ryood/PCM2704_HPA/IMG_20191226_172557.jpg

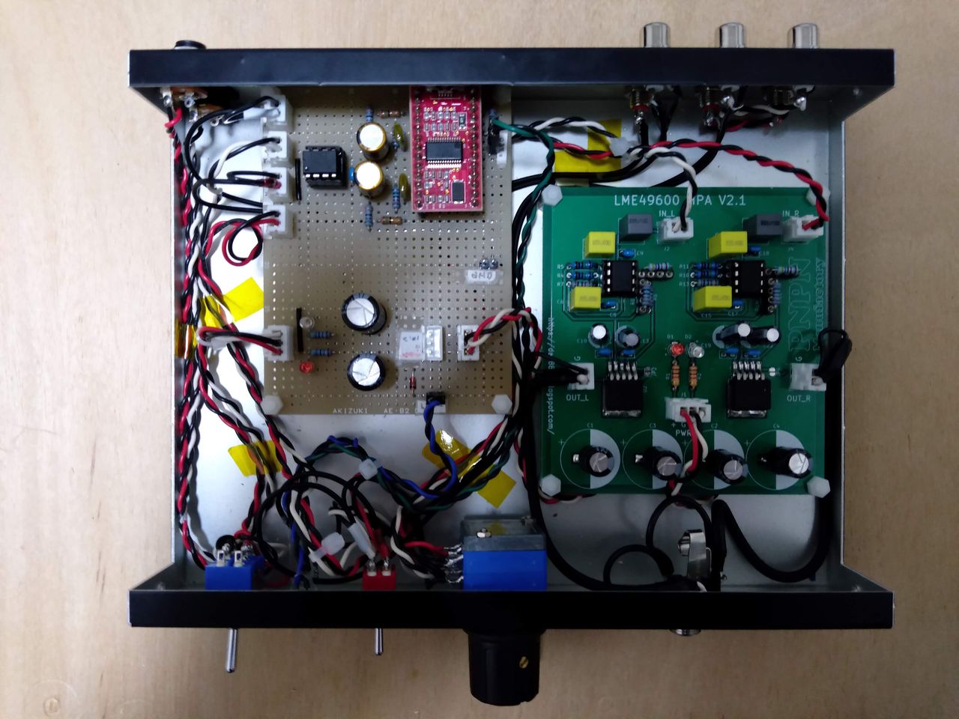
IMG_20191226_172557.jpg
