ryood/PCM2704_HPA/PCM2704_HPA_Substrate.jpg

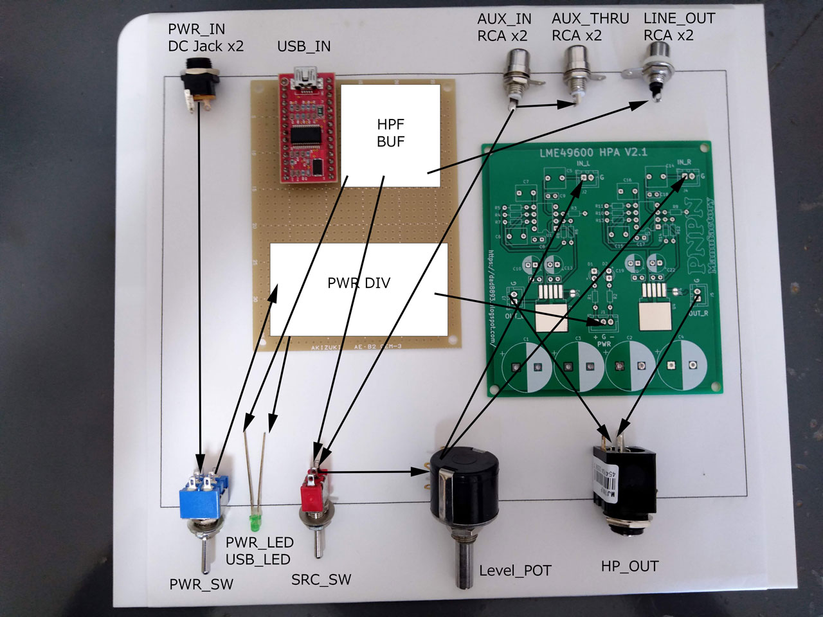
PCM2704_HPA_Substrate.jpg
