ryood/PCM2704_HPA/flitzing/PCM2704_HPA_Case_ブレッドボード.png

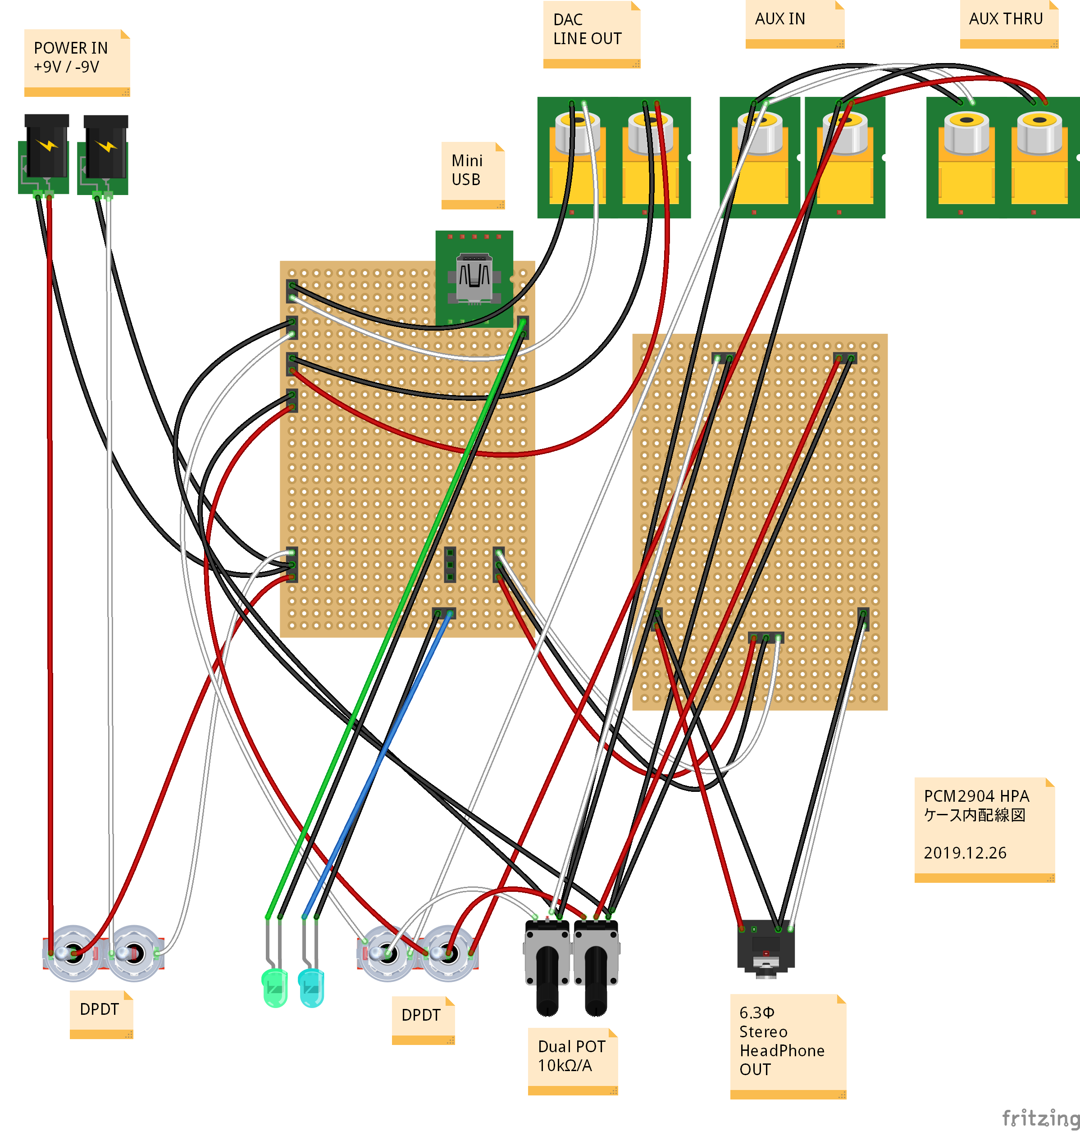
flitzing/PCM2704_HPA_Case_ブレッドボード.png
