ryood/PCM2704_HPA/flitzing/PCM2704_LineAmp_Snubber_ブレッドボード.png

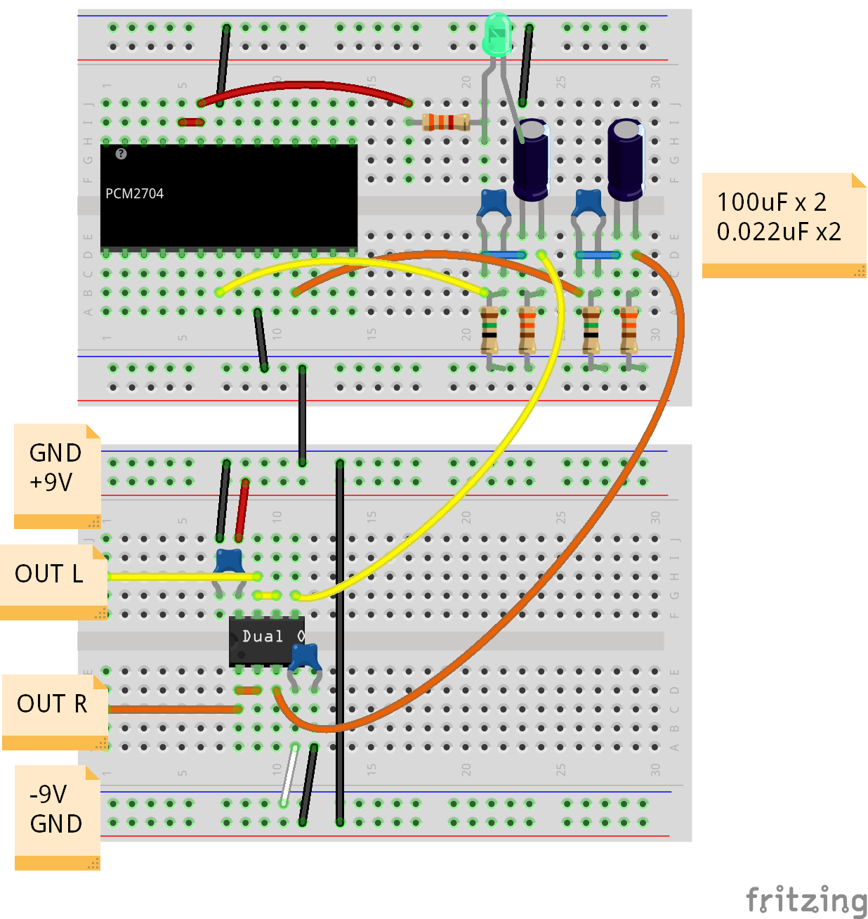
flitzing/PCM2704_LineAmp_Snubber_ブレッドボード.png
