ryood/PCM2704_HPA/flitzing/PCM2704_LineAmp_ブレッドボード.png

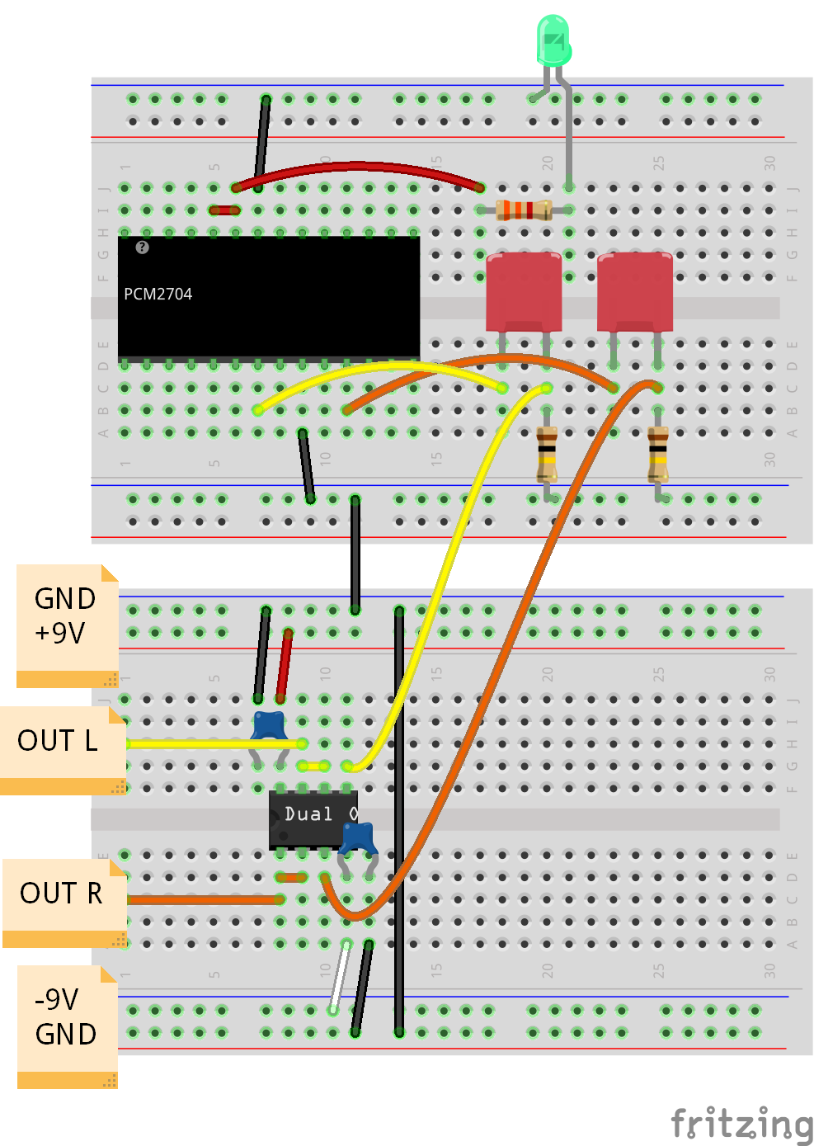
flitzing/PCM2704_LineAmp_ブレッドボード.png
