ryood/PCM2704_HPA/IMG_20190929_0001.jpg

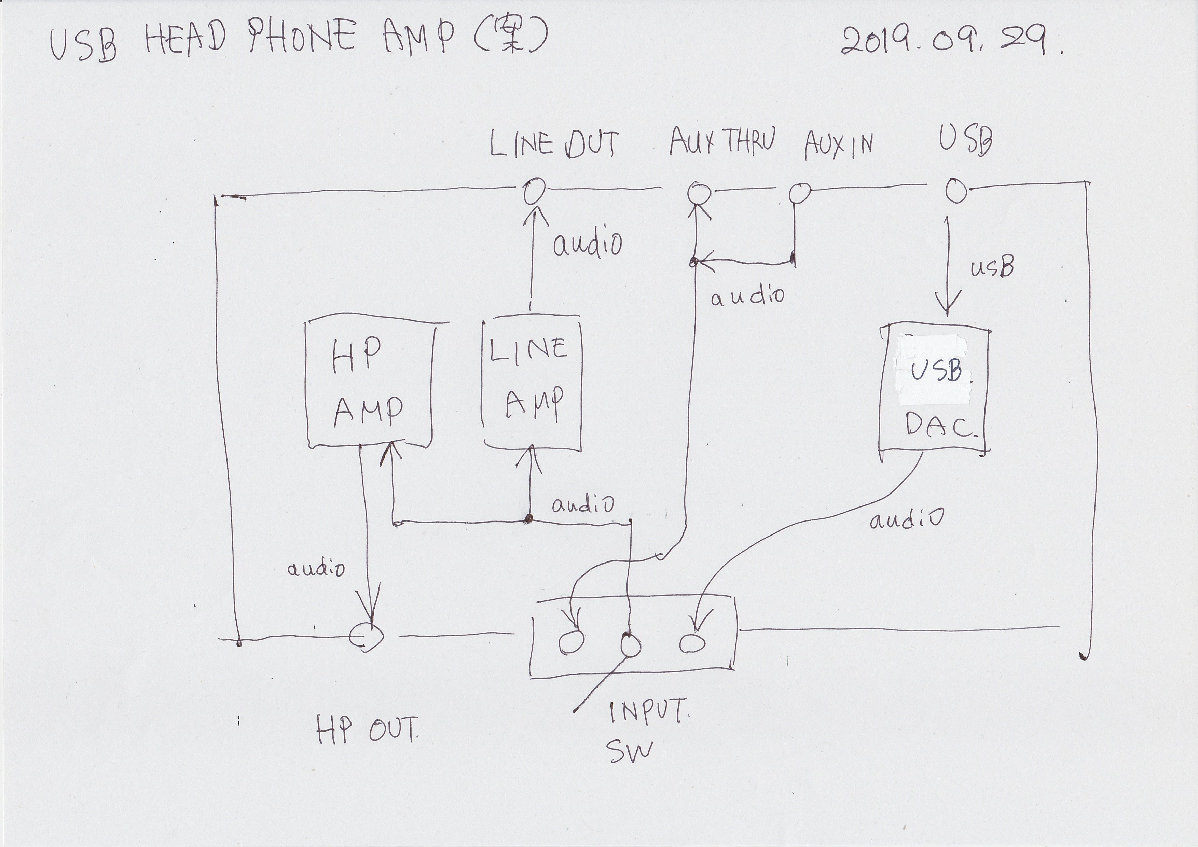
IMG_20190929_0001.jpg
