ryood/PCM2704_HPA/IMG_20191007_0001.jpg

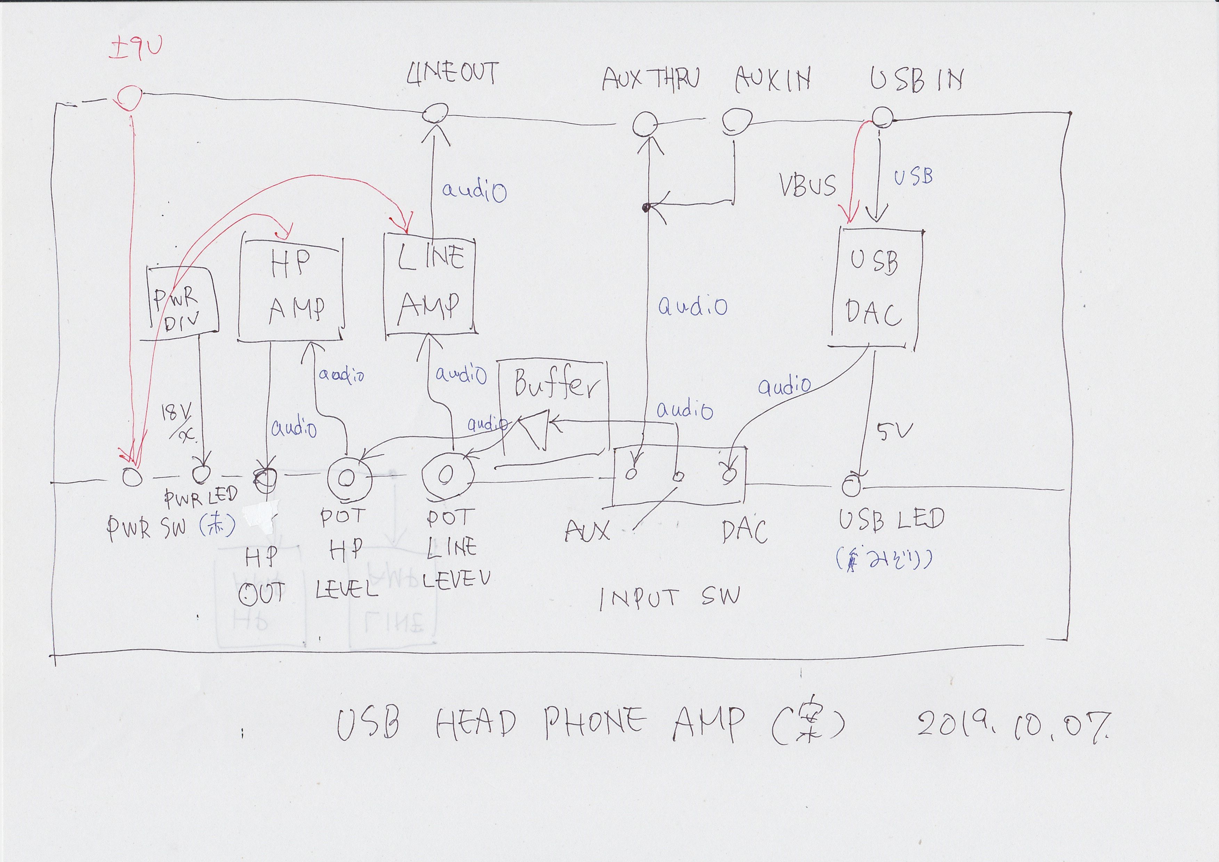
IMG_20191007_0001.jpg
