ryood/PCM2704_HPA/KiCAD/LME49600_HPA.jpg

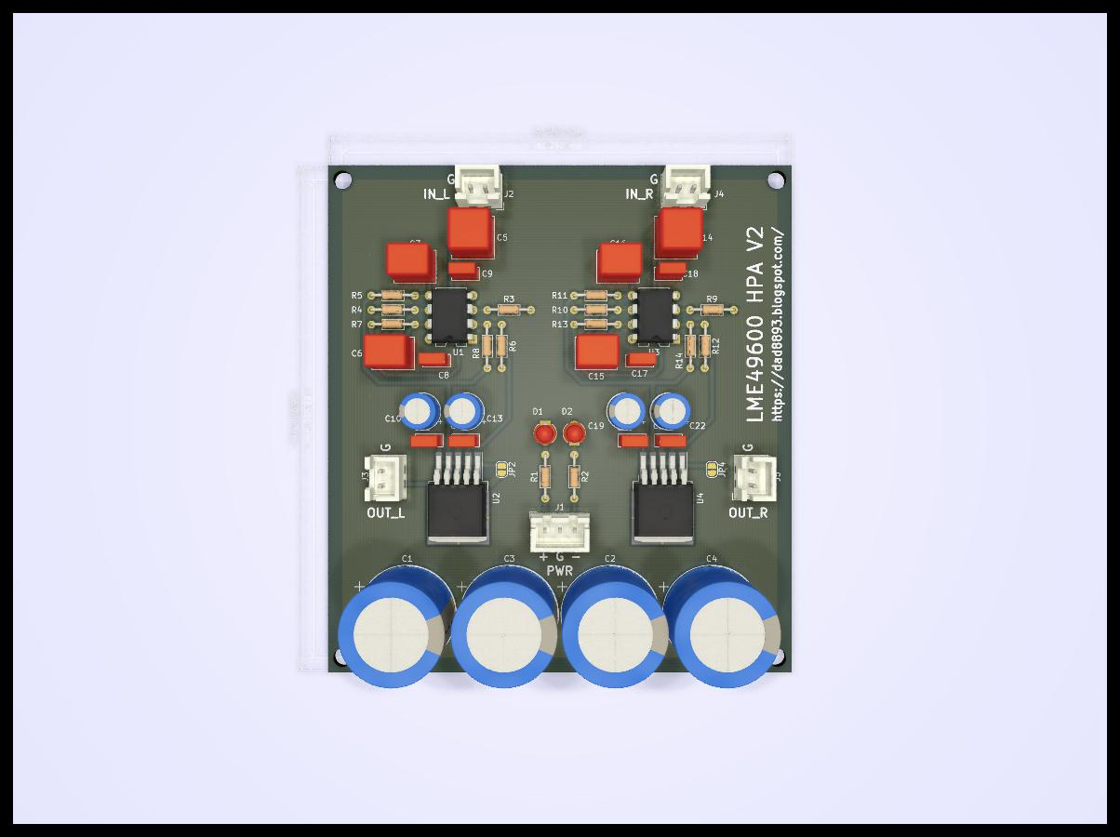
KiCAD/LME49600_HPA.jpg
