ryood/PCM2704_HPA/KiCAD/LME49600_HPA_3.jpg

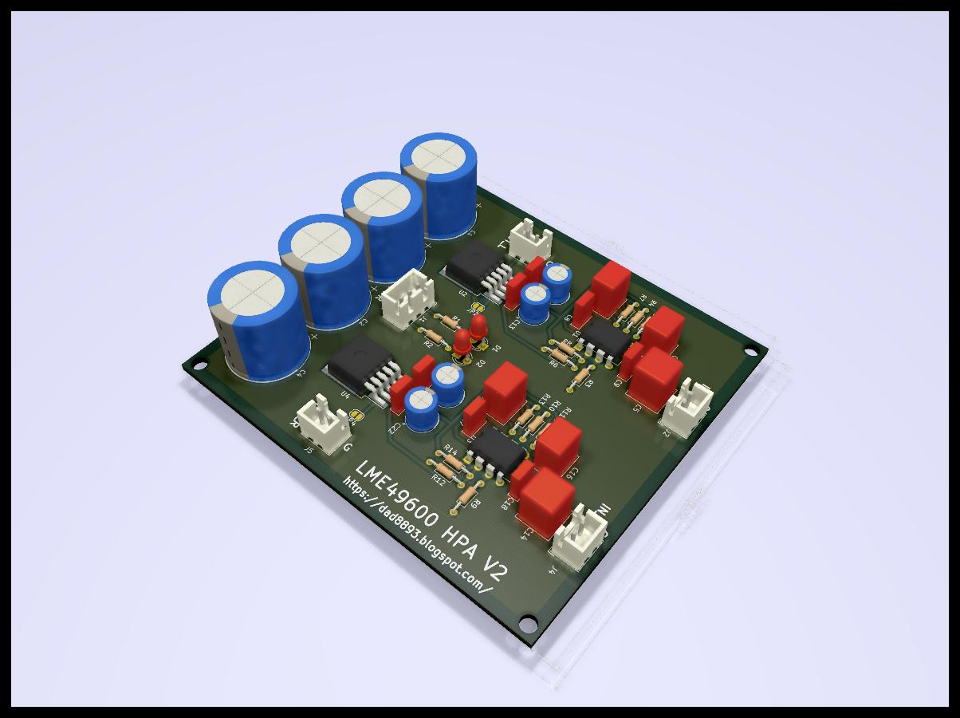
KiCAD/LME49600_HPA_3.jpg
