ryood/PCM2704_HPA/KiCAD/LME49600_HPA_rear.jpg

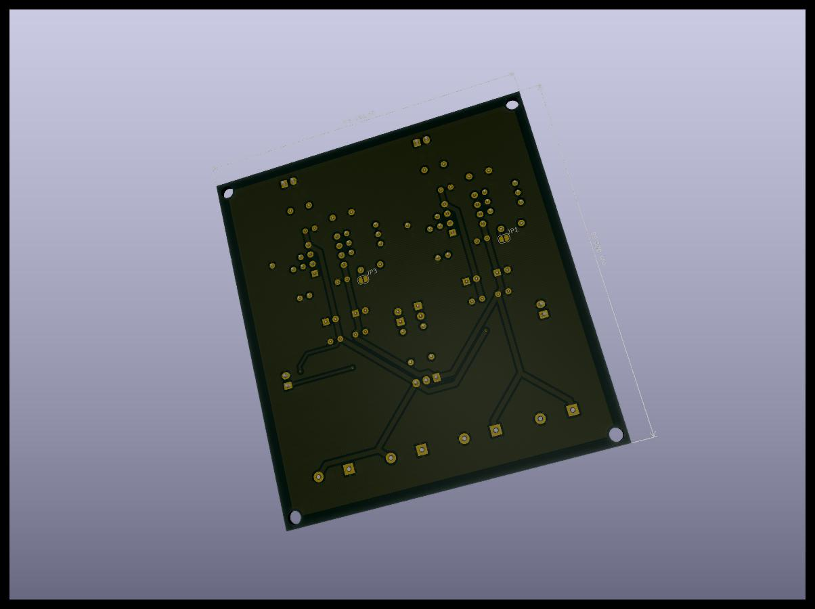
KiCAD/LME49600_HPA_rear.jpg
