ryood/PCM2704_HPA/KiCAD/LME49600_HPA_V2_sch.PNG

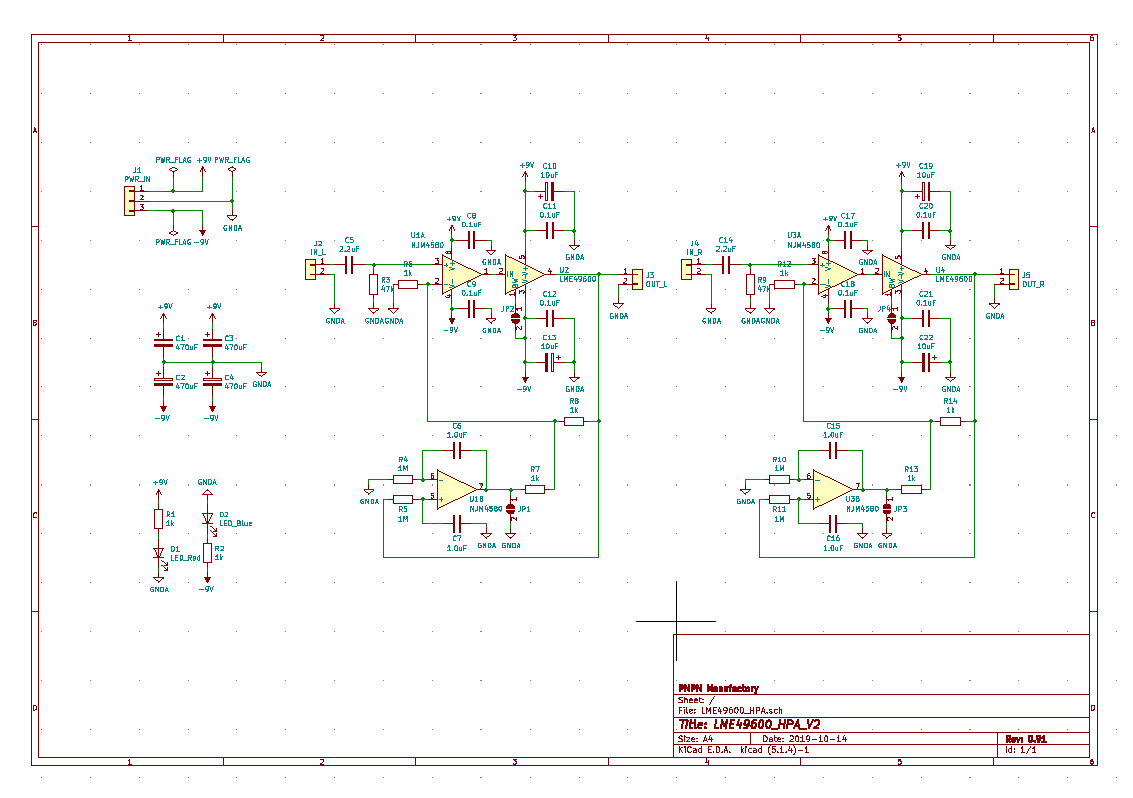
KiCAD/LME49600_HPA_V2_sch.PNG
