ryood/PCM2704_HPA/KiCAD/PCM2704_HPA_LineAmp_brd.png

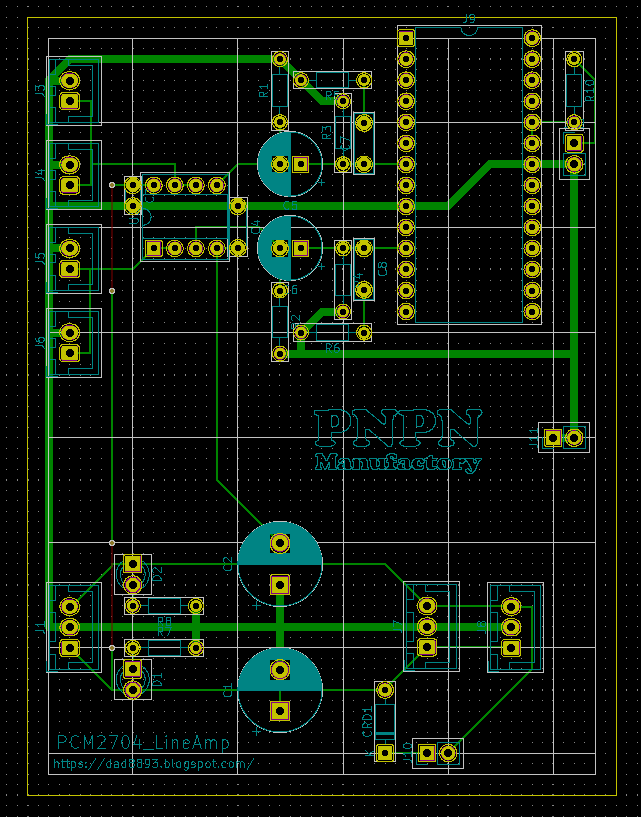
KiCAD/PCM2704_HPA_LineAmp_brd.png
