ryood/PCM2704_HPA/KiCAD/PCM2704_HPA_LineAmp_sch.png

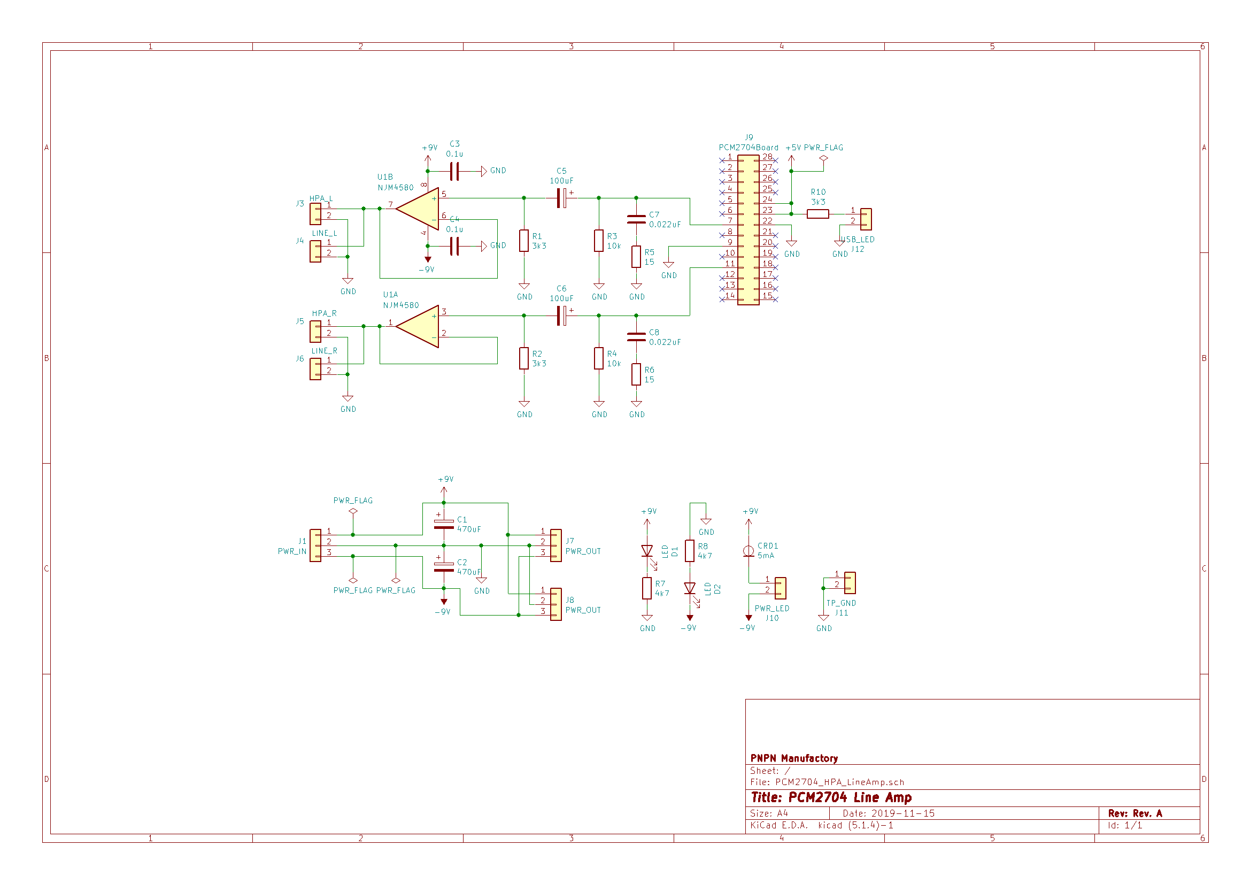
KiCAD/PCM2704_HPA_LineAmp_sch.png
