ryood/PCM2704_HPA/LME49600 HPA_sch.png

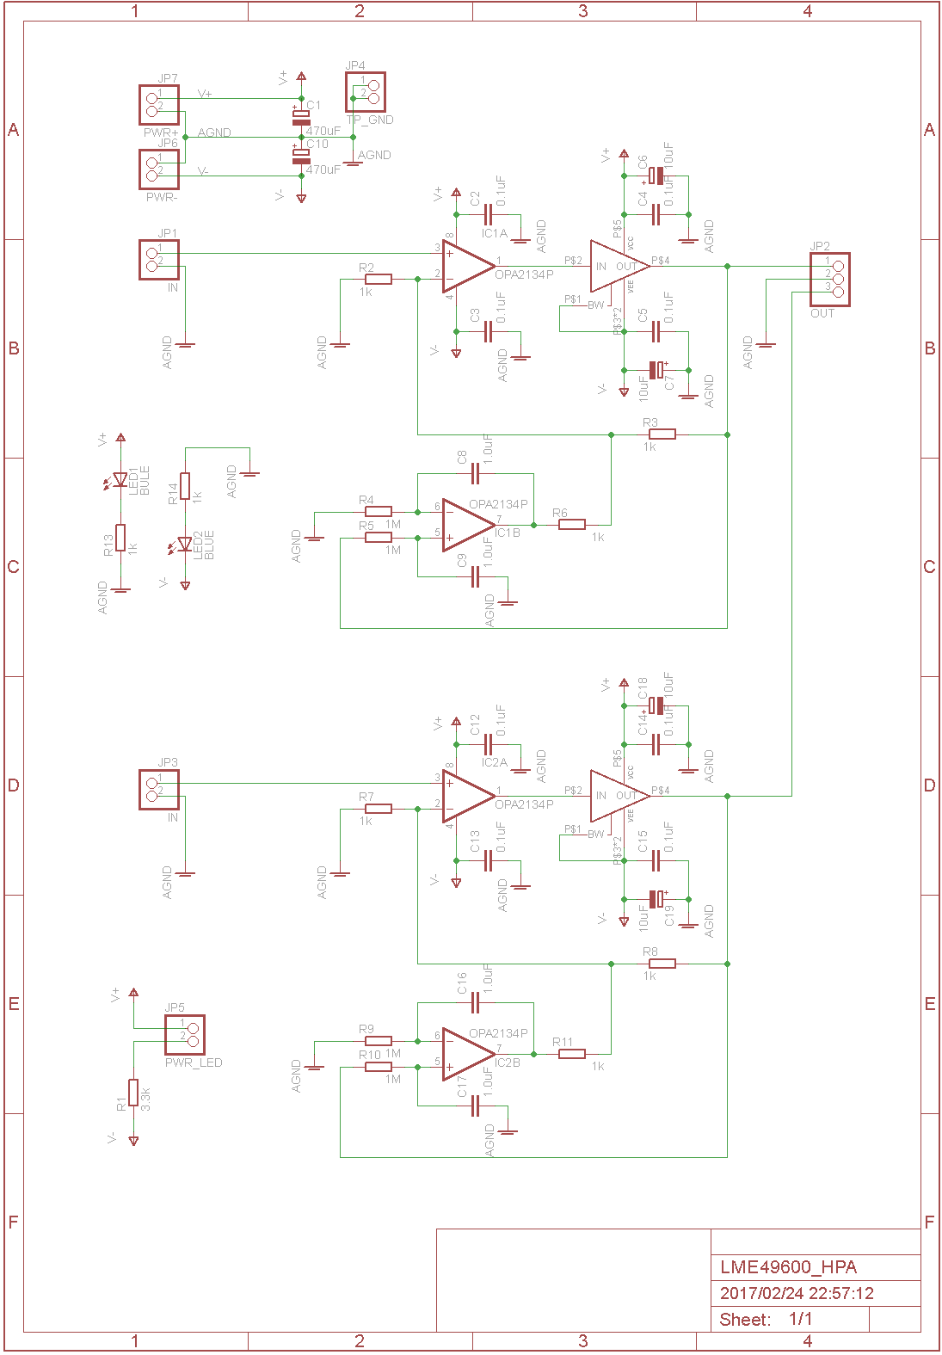
LME49600 HPA_sch.png
