ryood/PCM2704_HPA/spice/snubber_ac.png

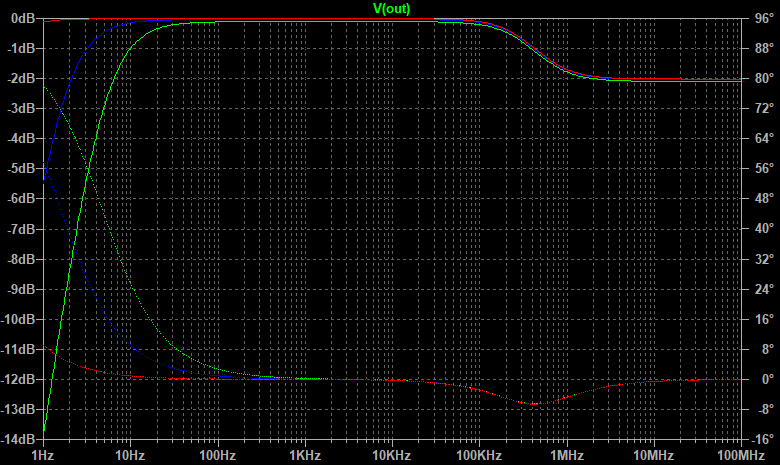
spice/snubber_ac.png
