ryood/PCM2704_HPA/spice/snubber_sch.png

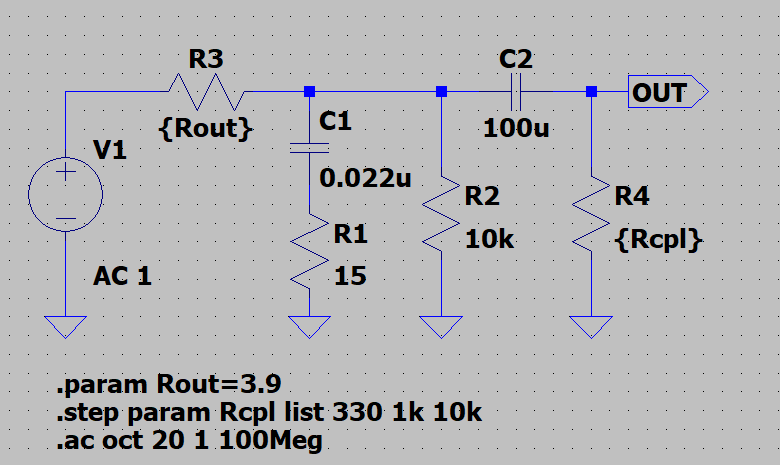
spice/snubber_sch.png
