ryood/PCM2704_HPA/logo/PNPN_Manufactory.dxf

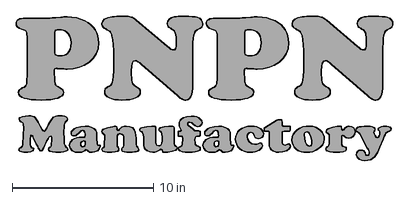
[picture p18: CAD file, 2019-10-29]
logo/PNPN_Manufactory.dxf
26.6 x 10.2 in
