ryood/PCM2704_HPA/(list of files, cad)

Other CAD files:
cad/PCM2704_HPA_Case.dwg
cad/PCM2704_HPA_Case_Bottom.dwg
logo/PNPN_Manufactory.dwg
