ryood/PCM2704_HPA/cad/PCM2704_HPA_Case.pdf

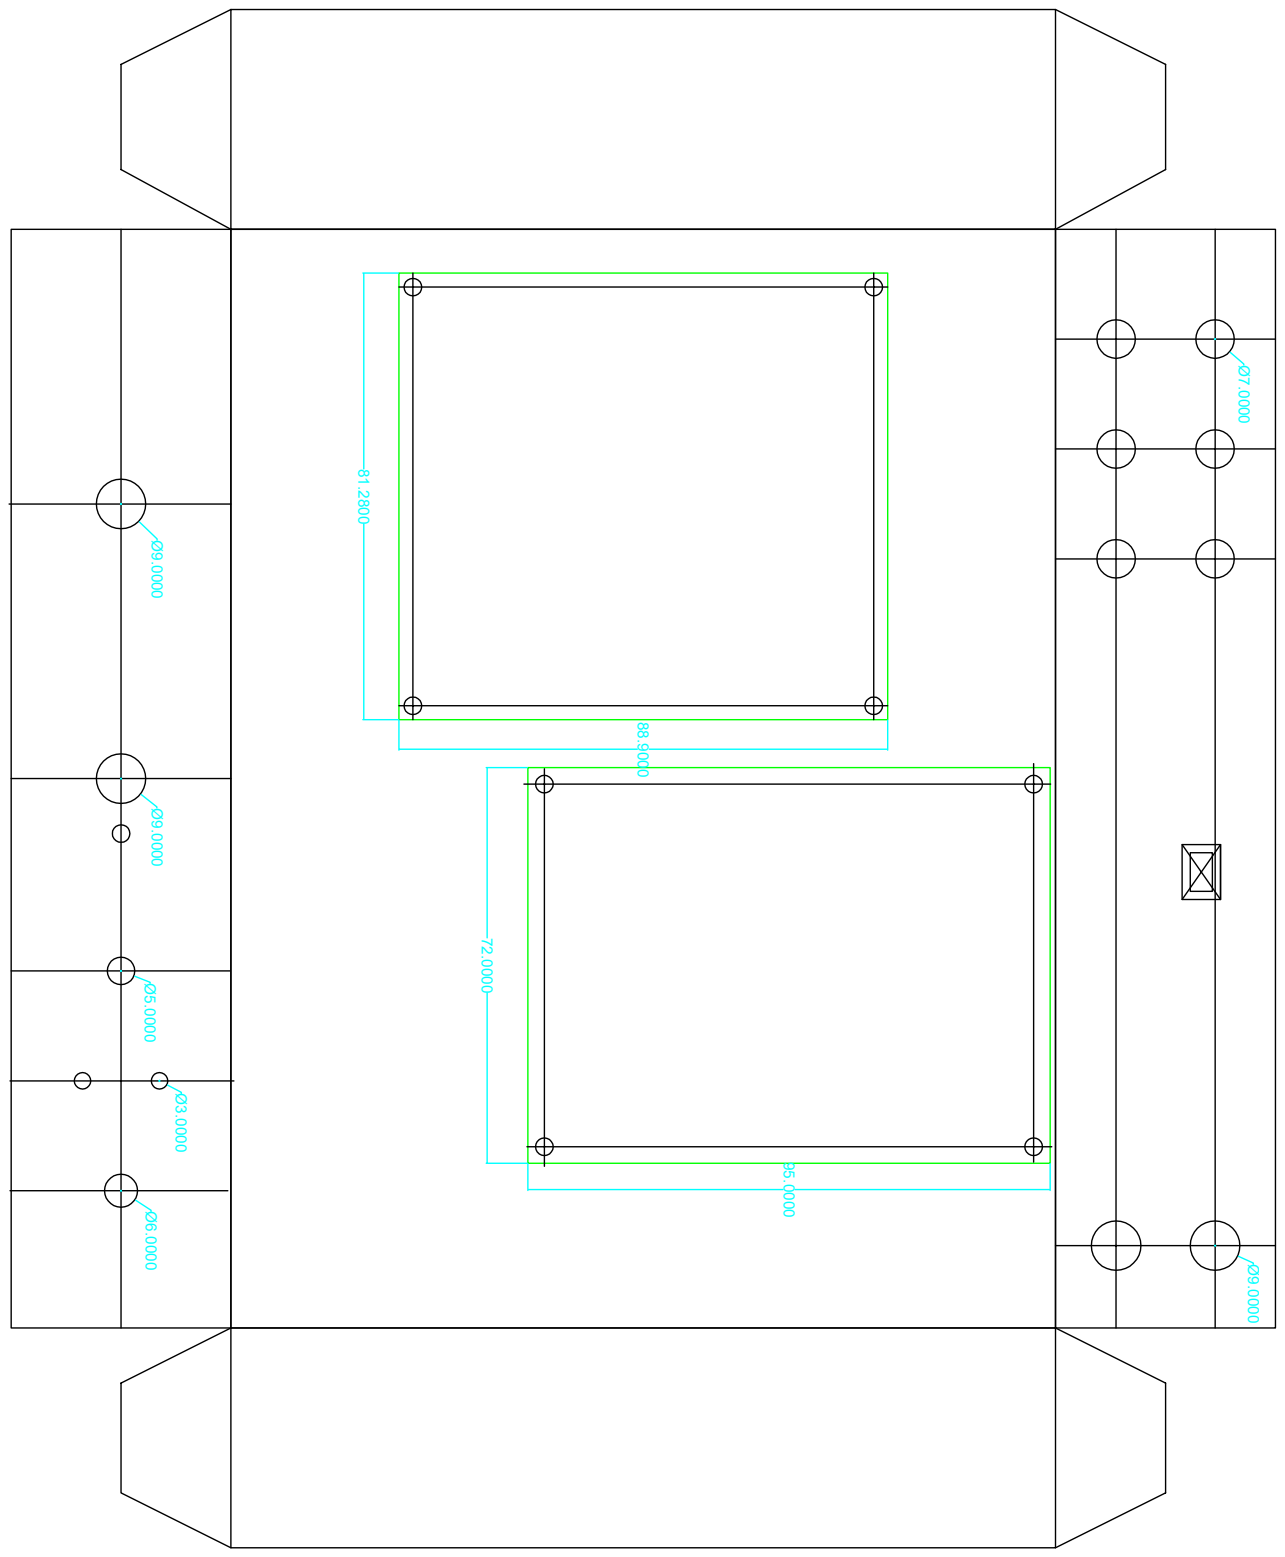
[picture p19: page 1]
