ryood/PCM2704_HPA/doc/AKI-DAC-REVC_1a_20171226.pdf

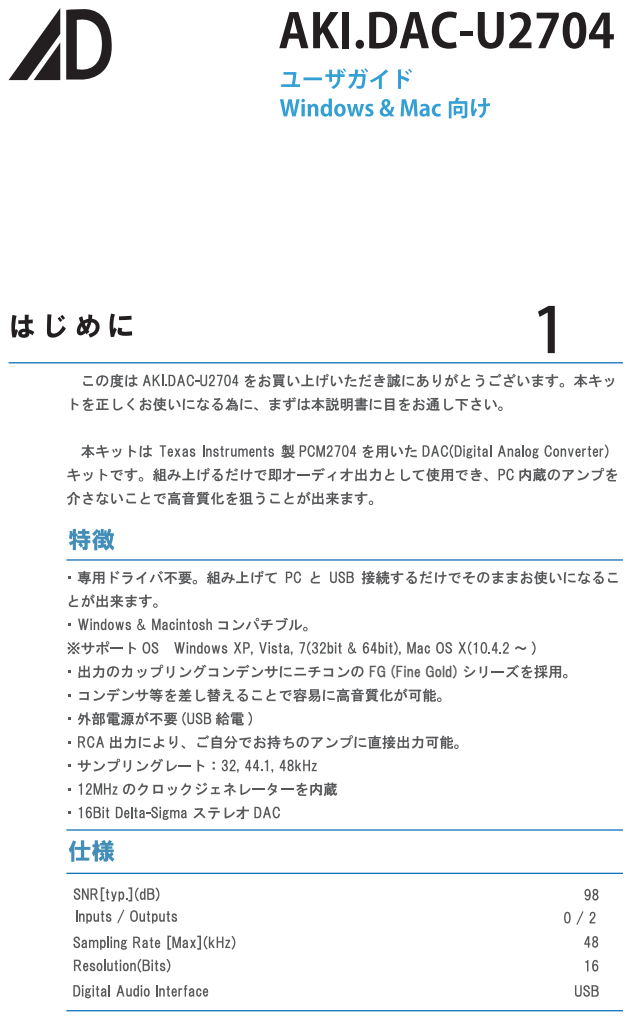
[picture p20: page 1]

FG (Fine Gold)

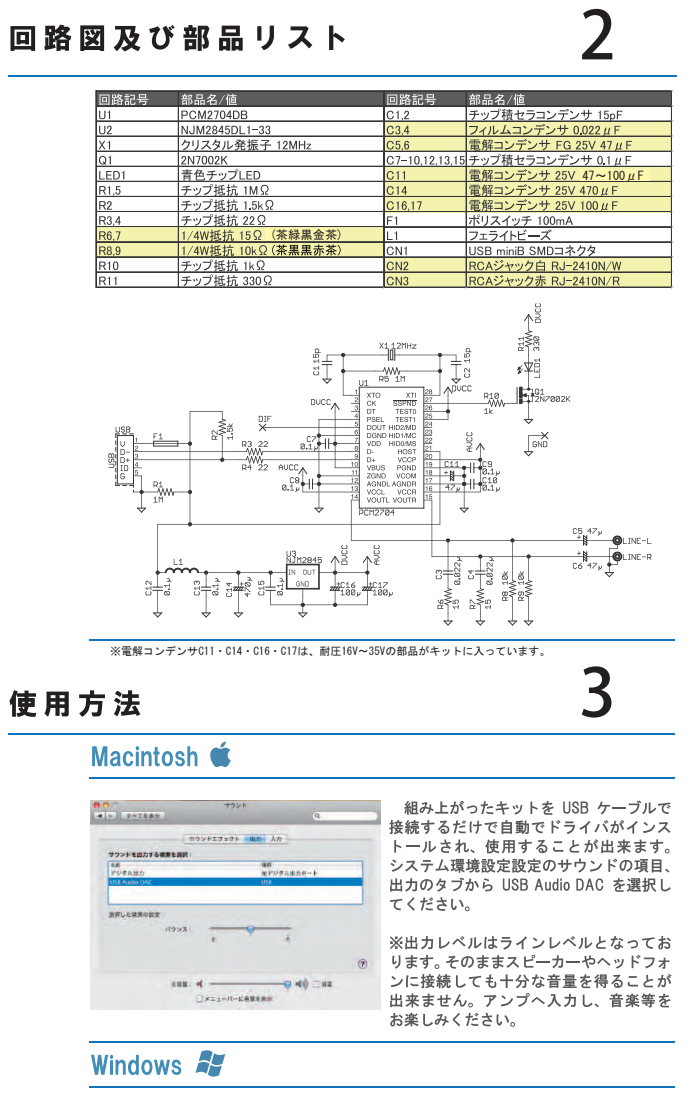
[picture p21: page 2]
(茶緑黒金茶); ※電解コンデンサC11・C14・C16・C17は、耐圧16V～35Vの部品がキットに入っています。

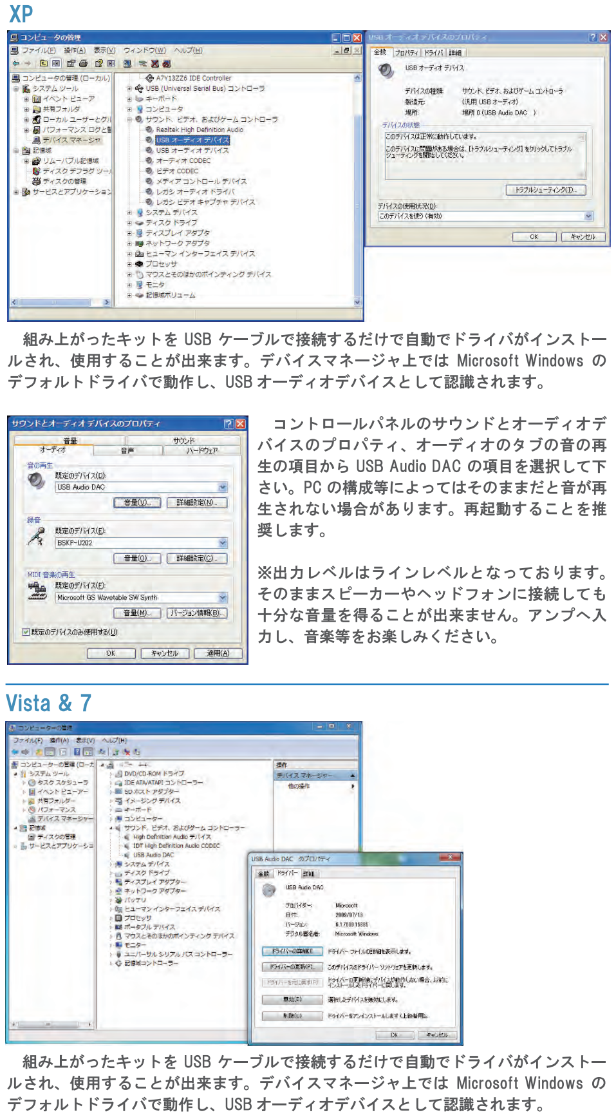
[picture p22: page 3]

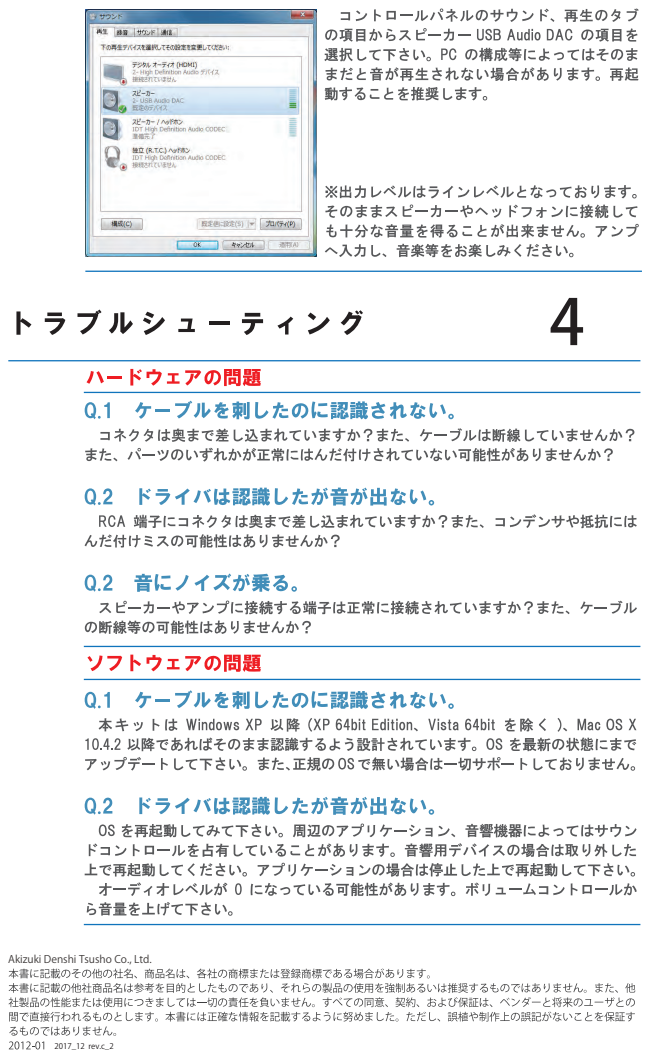
[picture p23: page 4]
2017_12 rev.c_2

Akizuki Denshi Tsusho Co., Ltd.
