ryood/PCM2704_HPA/spice/PCM2704_Snubber.asc

C1: cap; 0.022u
C2: cap; 100u
R1: res; 15
R2: res; 10k
R3: res; {Rout}
R4: res; {Rcpl}
V1: voltage; ""; AC 1
Named nets: 0, OUT
.param Rout=3.9
.ac oct 20 1 100Meg
.step param Rcpl list 330 1k 10k
