ryood/PCM2704_HPA/(list of files, drawings)

Other design files:
flitzing/PCM2704_HPA_Case.fzz
flitzing/PCM2704_LineAmp.fzz
flitzing/PCM2704_LineAmp_Snubber.fzz
