ryood/PCM2704_HPA/KiCAD/PCM2704_HPA_LineAmp/PCM2704_HPA_LineAmp.kicad_pcb

## KiCad design KiCAD/PCM2704_HPA_LineAmp/PCM2704_HPA_LineAmp.kicad_pcb (2019-11-29)

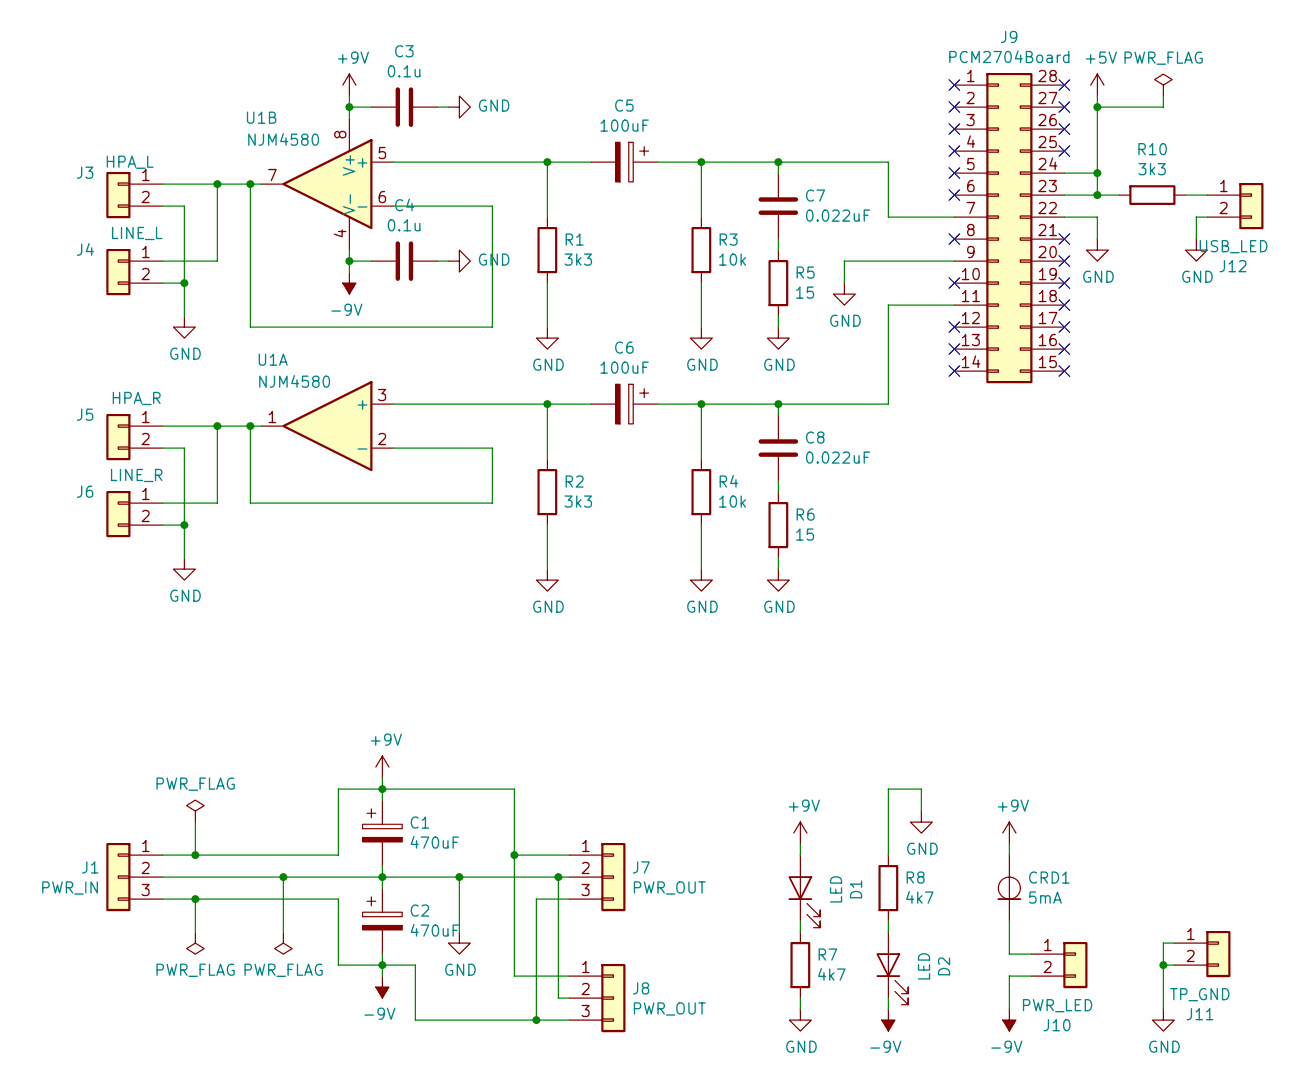
[picture p24: schematic PCM2704_HPA_LineAmp.sch, PCM2704 Line Amp]

Parts:
C1, C2: 470uF; CP_Radial_D10.0mm_P5.00mm
C3: 0.1u; C_Disc_D3.0mm_W1.6mm_P2.50mm
C4: 0.1u; C_Disc_D4.3mm_W1.9mm_P5.00mm
C5, C6: 100uF; CP_Radial_D7.5mm_P2.50mm
C7, C8: 0.022uF; C_Rect_L7.0mm_W2.0mm_P5.00mm
CRD1: 5mA; D_DO-35_SOD27_P7.62mm_Horizontal
D1, D2: LED; LED_D3.0mm
J1: PWR_IN; JST_XH_B3B-XH-A_1x03_P2.50mm_Vertical
J3: HPA_L; JST_XH_B2B-XH-A_1x02_P2.50mm_Vertical
J4: LINE_L; JST_XH_B2B-XH-A_1x02_P2.50mm_Vertical
J5: HPA_R; JST_XH_B2B-XH-A_1x02_P2.50mm_Vertical
J6: LINE_R; JST_XH_B2B-XH-A_1x02_P2.50mm_Vertical
J7, J8: PWR_OUT; JST_XH_B3B-XH-A_1x03_P2.50mm_Vertical
J9: PCM2704Board; DIP-28_W15.24mm
J10: PWR_LED; PinHeader_1x02_P2.54mm_Vertical
J11: TP_GND; PinHeader_1x02_P2.54mm_Vertical
J12: USB_LED; PinHeader_1x02_P2.54mm_Vertical
R1, R2, R10: 3k3; R_Axial_DIN0204_L3.6mm_D1.6mm_P7.62mm_Horizontal
R3, R4: 10k; R_Axial_DIN0204_L3.6mm_D1.6mm_P7.62mm_Horizontal
R5, R6: 15; R_Axial_DIN0204_L3.6mm_D1.6mm_P7.62mm_Horizontal
R7, R8: 4k7; R_Axial_DIN0204_L3.6mm_D1.6mm_P7.62mm_Horizontal
U1: NJM4580; DIP-8_W7.62mm_Socket

Connections:
+5V: J9.23, J9.24, R10.2
+9V: C1.1, C3.1, CRD1.2 (A), D1.2 (A), J1.1, J7.1, J8.1, U1.8 (V+)
-9V: C2.2, C4.2, D2.1 (K), J1.3, J7.3, J8.3, J10.2, U1.4 (V-)
GND: C1.2, C2.1, C3.2, C4.1, J1.2, J3.2, J4.2, J5.2, J6.2, J7.2, J8.2, J9.9, J9.22, J11.1, J11.2, J12.2, R1.2, R2.2, R3.2, R4.2, R5.2, R6.2, R7.2, R8.1
unnamed: C5.1, C7.1, J9.7, R3.1
unnamed: C5.2, R1.1, U1.5 (+)
unnamed: C6.1, C8.1, J9.11, R4.1
unnamed: C6.2, R2.1, U1.3 (+)
unnamed: C7.2, R5.1
unnamed: C8.2, R6.1
unnamed: CRD1.1 (K), J10.1
unnamed: D1.1 (K), R7.1
unnamed: D2.2 (A), R8.2
unnamed: J3.1, J4.1, U1.6 (-), U1.7
unnamed: J5.1, J6.1, U1.1, U1.2 (-)
unnamed: J12.1, R10.1

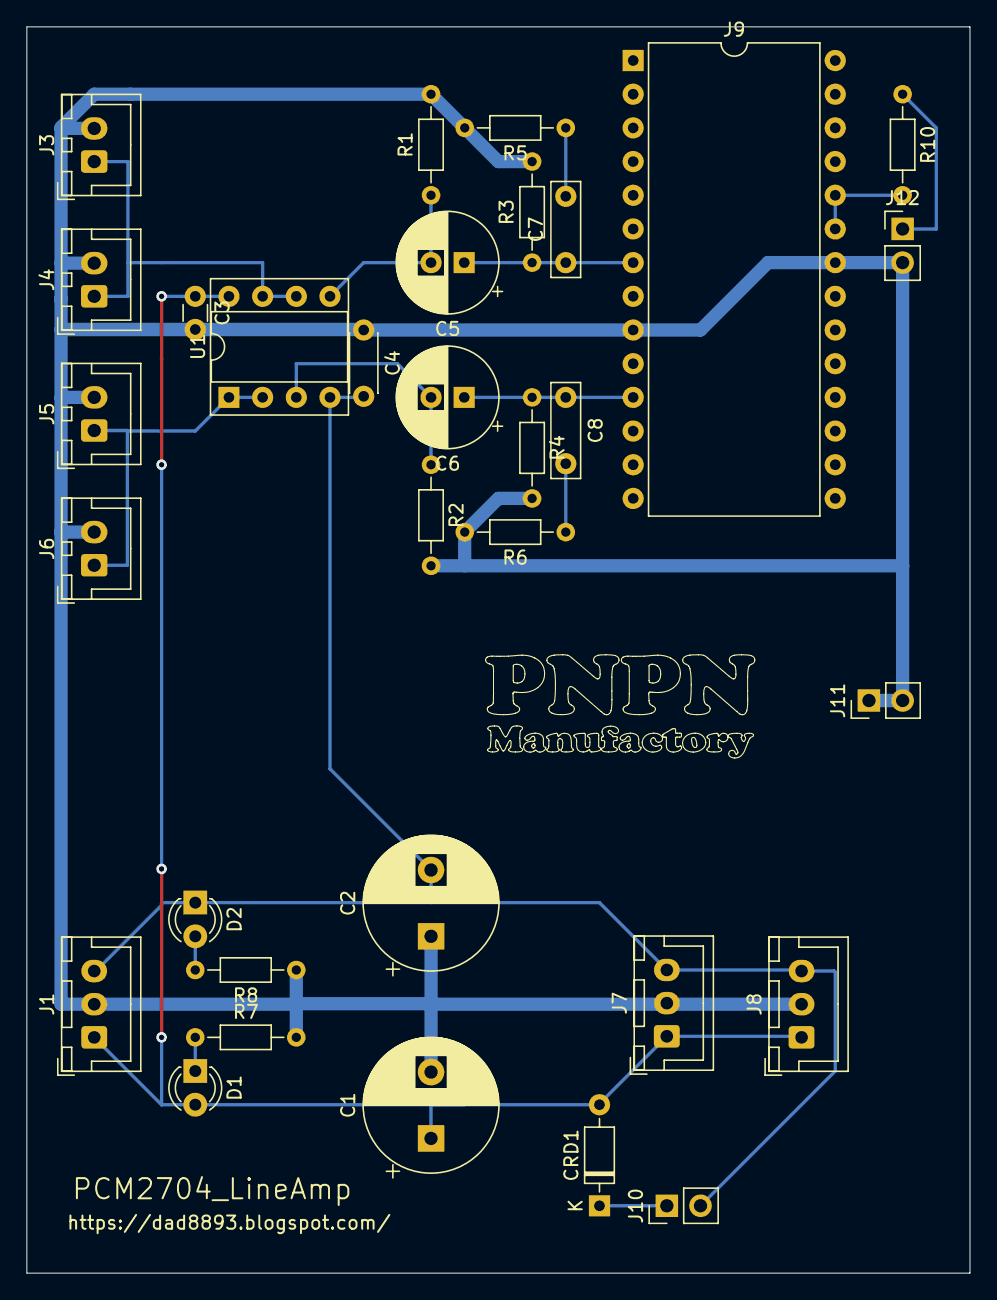
[picture p25: board PCM2704_HPA_LineAmp.kicad_pcb from above]

Board: 2 copper layers, 71.1 x 94.0 mm, 32 parts (0 on the bottom side), 16 nets.
