ryood/PCM2704_HPA/KiCAD/LME49600_HPA/LME49600_HPA.kicad_pcb

## KiCad design KiCAD/LME49600_HPA/LME49600_HPA.kicad_pcb (2019-10-29)

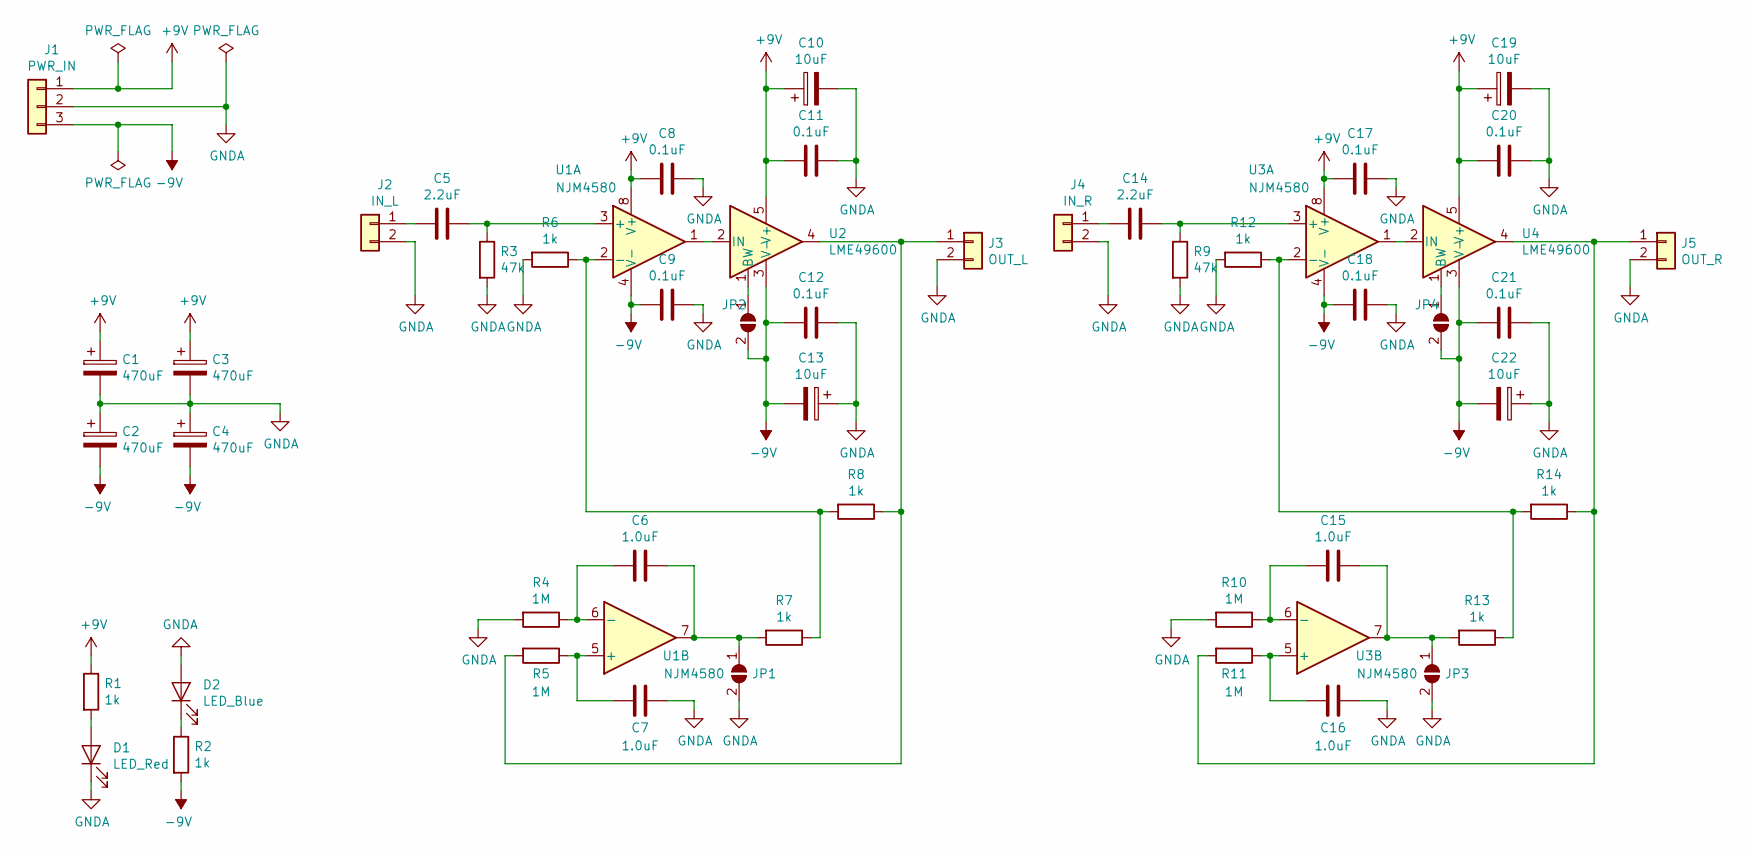
[picture p26: schematic LME49600_HPA.sch, LME49600_HPA_V2.1]

Parts:
C1, C2, C3, C4: 470uF; CP_Radial_D17.0mm_P7.50mm
C5, C14: 2.2uF; C_Rect_L7.2mm_W7.2mm_P5.00mm_FKS2_FKP2_MKS2_MKP2
C6, C7, C15, C16: 1.0uF; C_Rect_L7.2mm_W5.5mm_P5.00mm_FKS2_FKP2_MKS2_MKP2
C8, C9, C11, C12, C17, C18, C20, C21: 0.1uF; C_Rect_L4.6mm_W2.0mm_P2.50mm_MKS02_FKP02
C10, C13, C19, C22: 10uF; CP_Radial_D6.3mm_P2.50mm
D1: LED_Red; LED_D3.0mm
D2: LED_Blue; LED_D3.0mm
J1: PWR_IN; JST_XH_B3B-XH-A_1x03_P2.50mm_Vertical
J2: IN_L; JST_XH_B2B-XH-A_1x02_P2.50mm_Vertical
J3: OUT_L; JST_XH_B2B-XH-A_1x02_P2.50mm_Vertical
J4: IN_R; JST_XH_B2B-XH-A_1x02_P2.50mm_Vertical
J5: OUT_R; JST_XH_B2B-XH-A_1x02_P2.50mm_Vertical
JP1, JP2, JP3, JP4: SolderJumper_2_Open; SolderJumper-2_P1.3mm_Open_RoundedPad1.0x1.5mm
R1, R2, R6, R7, R8, R12, R13, R14: 1k; R_Axial_DIN0207_L6.3mm_D2.5mm_P7.62mm_Horizontal
R3, R9: 47k; R_Axial_DIN0207_L6.3mm_D2.5mm_P7.62mm_Horizontal
R4, R5, R10, R11: 1M; R_Axial_DIN0207_L6.3mm_D2.5mm_P7.62mm_Horizontal
U1, U3: NJM4580; DIP-8_W7.62mm_Socket_LongPads
U2, U4: LME49600; TO-263-5_TabPin3

Connections:
+9V: C1.1, C3.1, C8.2, C10.1, C11.2, C17.2, C19.1, C20.2, J1.1, R1.1, U1.8 (V+), U2.5 (V+), U3.8 (V+), U4.5 (V+)
-9V: C2.2, C4.2, C9.2, C12.2, C13.2, C18.2, C21.2, C22.2, J1.3, JP2.2 (B), JP4.2 (B), R2.2, U1.4 (V-), U2.3 (V-), U3.4 (V-), U4.3 (V-)
GNDA: C1.2, C2.1, C3.2, C4.1, C7.1, C8.1, C9.1, C10.2, C11.1, C12.1, C13.1, C16.1, C17.1, C18.1, C19.2, C20.1, C21.1, C22.1, D1.1 (K), D2.2 (A), J1.2, J2.2, J3.2, J4.2, J5.2, JP1.2 (B), JP3.2 (B), R3.2, R4.2, R6.2, R9.2, R10.2, R12.2
unnamed: C5.1, R3.1, U1.3 (+)
unnamed: C5.2, J2.1
unnamed: C6.1, JP1.1 (A), R7.2, U1.7
unnamed: C6.2, R4.1, U1.6 (-)
unnamed: C7.2, R5.1, U1.5 (+)
unnamed: C14.1, R9.1, U3.3 (+)
unnamed: C14.2, J4.1
unnamed: C15.1, JP3.1 (A), R13.2, U3.7
unnamed: C15.2, R10.1, U3.6 (-)
unnamed: C16.2, R11.1, U3.5 (+)
unnamed: D1.2 (A), R1.2
unnamed: D2.1 (K), R2.1
unnamed: J3.1, R5.2, R8.1, U2.4
unnamed: J5.1, R11.2, R14.1, U4.4
unnamed: JP2.1 (A), U2.1 (BW)
unnamed: JP4.1 (A), U4.1 (BW)
unnamed: R6.1, R7.1, R8.2, U1.2 (-)
unnamed: R12.1, R13.1, R14.2, U3.2 (-)
unnamed: U1.1, U2.2 (IN)
unnamed: U3.1, U4.2 (IN)

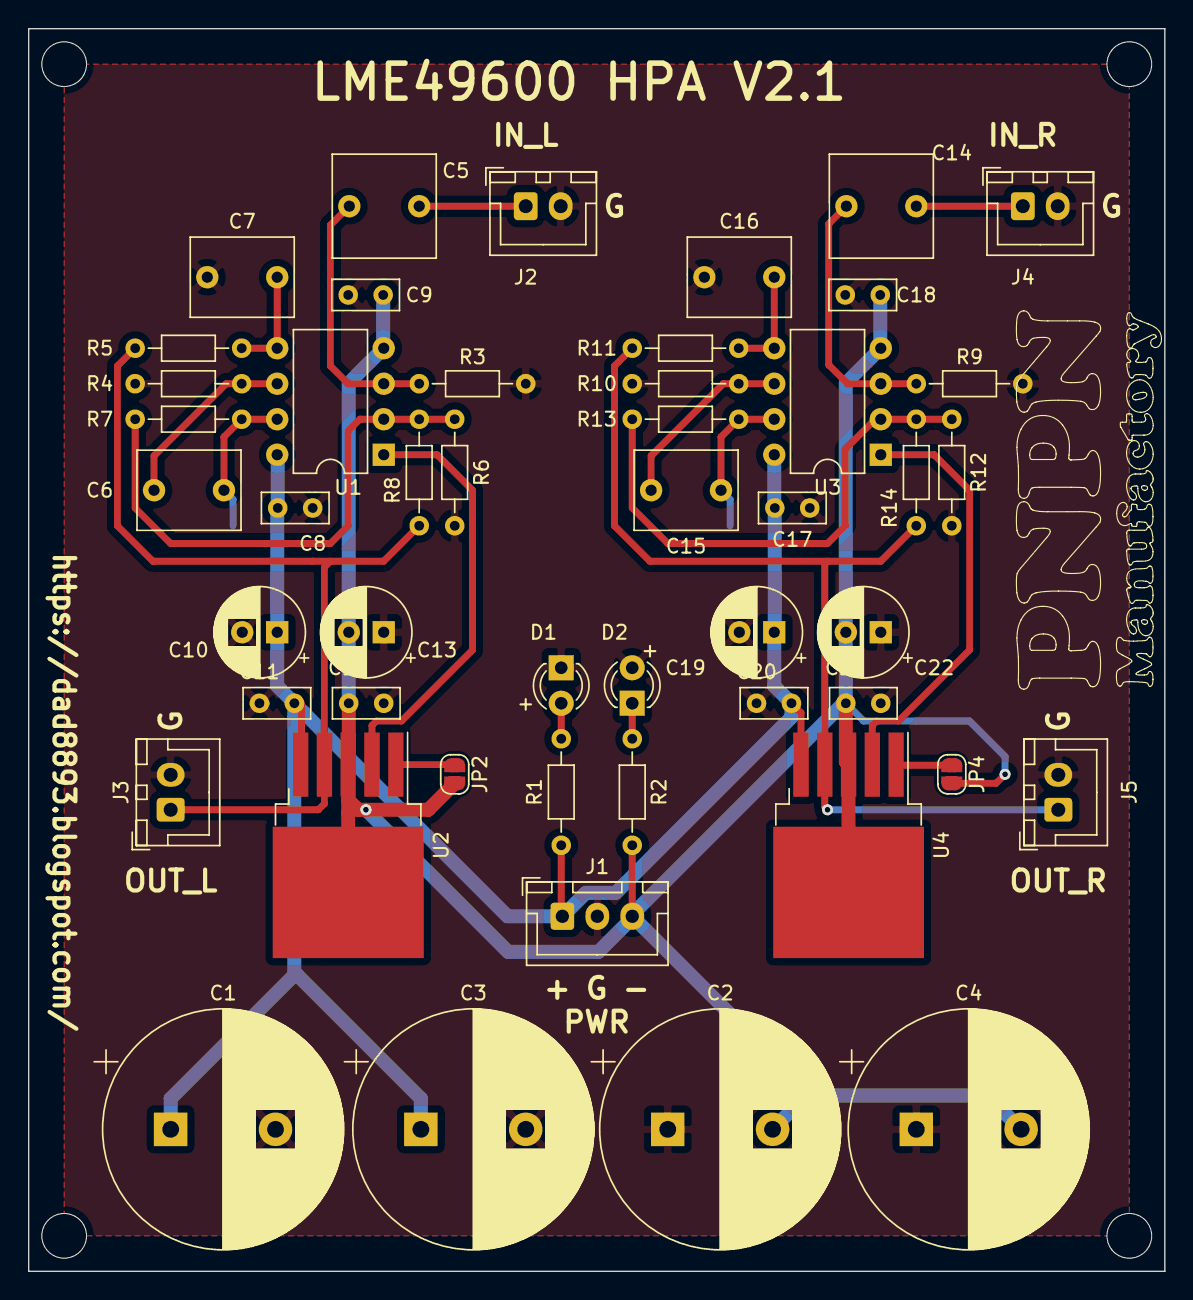
[picture p27: board LME49600_HPA.kicad_pcb from above]

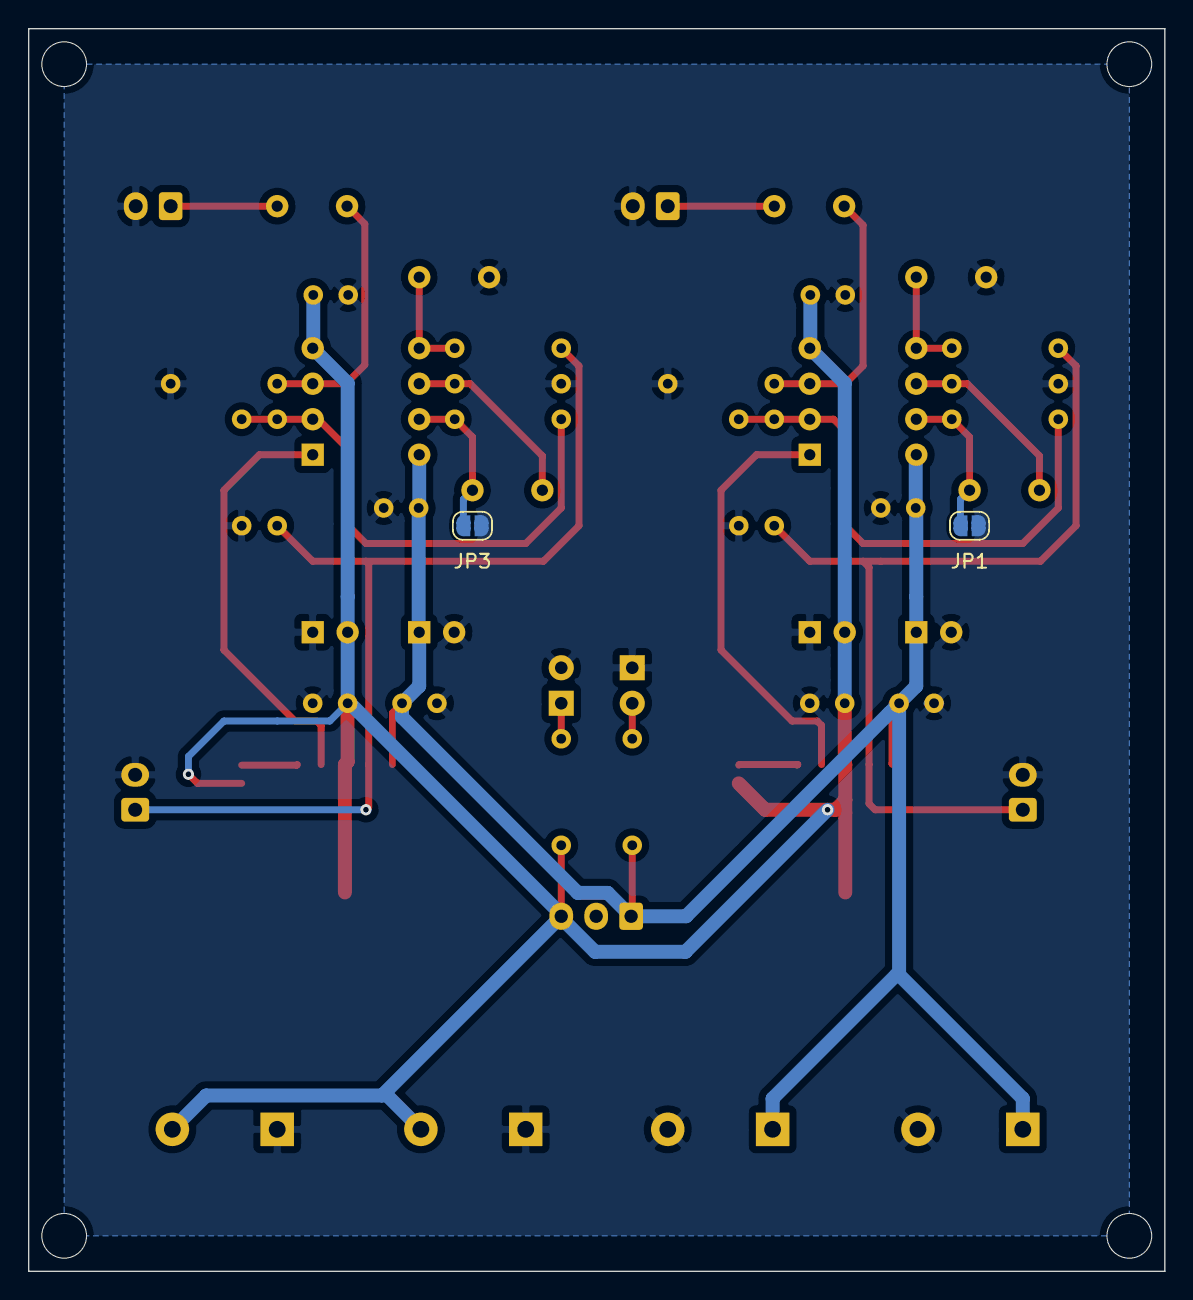
[picture p28: board LME49600_HPA.kicad_pcb from below]

Board: 2 copper layers, 81.3 x 88.9 mm, 51 parts (2 on the bottom side), 23 nets.
