ryood/PCM2704_HPA/(commit log)

2019-10-15 Add: LME49600_HPA KiCAD files.
    [LME49600_HPA-B_Cu.gbl, LME49600_HPA-B_Mask.gbs, LME49600_HPA-B_Paste.gbp, LME49600_HPA-B_SilkS.gbo, LME49600_HPA-Edge_Cuts.gm1, LME49600_HPA-F_Cu.gtl, LME49600_HPA-F_Mask.gts, LME49600_HPA-F_Paste.gtp]
2019-10-29 Add: PCM2704 HPA ブロック図.xlsx
    [LME49600_HPA-B_Cu.gbl, LME49600_HPA-B_Mask.gbs, LME49600_HPA-B_Paste.gbp, LME49600_HPA-B_SilkS.gbo, LME49600_HPA-Edge_Cuts.gm1, LME49600_HPA-F_Cu.gtl, LME49600_HPA-F_Mask.gts, LME49600_HPA-F_Paste.gtp]
2019-10-29 Update: PCM2704 HPA ブロック図.xlsx
    [PCM2704 HPA ブロック図.xlsx]
2019-11-08 Add: PCM2704_LineAmp
    [PCM2704 HPA ブロック図 AUXバッファあり.xlsx, PCM2704 HPA ブロック図.xlsx, PCM2704 HPA 基板配置.xlsx, PCM2704_HPA_LineAmp.sch, PCM2704_LineAmp_Snubber.fzz, スナバインピーダンス.xlsx]
2019-11-09 Update: PCM2704_HPA_LineAmp board design
    [PCM2704_HPA_LineAmp.kicad_pcb, PCM2704_HPA_LineAmp.sch]
2019-11-29 Add: Case design
    [PCM2704_HPA_Case.dwg, PCM2704_HPA_Case_Bottom.dwg, PCM2704_HPA_LineAmp.kicad_pcb, PCM2704_HPA_LineAmp.sch]
2020-01-03 Update: Case design
    [PCM2704_HPA_Case.dwg, PCM2704_HPA_Case.fzz]
2020-01-26 Add: テスト表
    [PCM2704_HPA_LineAmp_テスト表.xlsx]
